robertert/FloraV2/components/flora_board/include/flora_board.h

/**
 * @file flora_board.h
 * @brief Mapa pinow jednostki dolnej (bryla): ESP32-S3 DevKitC-1 N16R8.
 *
 * Jedno miejsce prawdy dla pinoutu. Zmieniasz tu, nie w sterownikach.
 *
 * Piny, ktorych NIE wolno uzywac na tej plytce:
 *   0, 3, 45, 46  - strapping (stan przy boot decyduje o trybie startu)
 *   19, 20        - USB D-/D+
 *   35, 36, 37    - PSRAM (wariant N16R8)
 *   43, 44        - UART0 (konsola, idf.py monitor)
 *   38, 48        - dioda RGB
 */
#pragma once

#include "driver/gpio.h"

/* ---- Naped: Cytron MDD10A (PWM + DIR, logika 3,3V) ---- */
#define FLORA_PIN_MOTOR_L_PWM GPIO_NUM_4
#define FLORA_PIN_MOTOR_L_DIR GPIO_NUM_5
#define FLORA_PIN_MOTOR_R_PWM GPIO_NUM_6
#define FLORA_PIN_MOTOR_R_DIR GPIO_NUM_7

/* ---- Enkodery Halla JGB37-520, 11 PPR na wale silnika ---- */
#define FLORA_PIN_ENC_L_A GPIO_NUM_15
#define FLORA_PIN_ENC_L_B GPIO_NUM_16
#define FLORA_PIN_ENC_R_A GPIO_NUM_17
#define FLORA_PIN_ENC_R_B GPIO_NUM_18

/* ---- I2C (INA226) ---- */
#define FLORA_PIN_I2C_SDA GPIO_NUM_8
#define FLORA_PIN_I2C_SCL GPIO_NUM_9

/* ---- UART do glowicy masztu ---- */
#define FLORA_PIN_HEAD_TX GPIO_NUM_11
#define FLORA_PIN_HEAD_RX GPIO_NUM_12

/* ---- Ultradzwieki JSN-SR04T (wspolny TRIG, echo przez dzielnik) ---- */
#define FLORA_PIN_US_TRIG GPIO_NUM_13
#define FLORA_PIN_US_ECHO_1 GPIO_NUM_14
#define FLORA_PIN_US_ECHO_2 GPIO_NUM_21
#define FLORA_PIN_US_ECHO_3 GPIO_NUM_47

/* ---- Pozostale peryferia ---- */
#define FLORA_PIN_SOIL_ADC GPIO_NUM_1     /**< wilgotnosc gleby, ADC1 kanal 0 */
#define FLORA_PIN_WATER_LEVEL GPIO_NUM_10 /**< XKC-Y25, wyjscie podciagniete do 3,3V */
#define FLORA_PIN_DS18B20 GPIO_NUM_41     /**< 1-Wire, + 4,7k do 3,3V */
#define FLORA_PIN_MAST_SWITCH GPIO_NUM_39 /**< IRF4905 + NPN, klucz 12V masztu */
#define FLORA_PIN_PUMP GPIO_NUM_40        /**< D4184, pompka perystaltyczna */

/* ---- Parametry mechaniczne napedu ----
 * Enkoder daje 11 impulsow na obrot WALU SILNIKA. PCNT w trybie kwadraturowym
 * zlicza 4 zbocza na impuls, wiec na obrot wyjscia przekladni przypada:
 *     11 * 4 * przelozenie
 * Przy 270:1 to 11880 zliczen na obrot kola.
 */
#define FLORA_ENCODER_PPR 11      /**< impulsow na obrot walu silnika */
#define FLORA_ENCODER_QUAD_MULT 4 /**< dekodowanie x4 (oba zbocza, oba kanaly) */
#define FLORA_GEAR_RATIO 270.0f /**< potwierdzone przy zakupie silnikow 27.10.2026 */

/**
 * SKUTECZNA srednica kola, nie nominalna.
 *
 * Kola maja nominalnie 130 mm, ale pod ciezarem robota guma sie ugina
 * i promien toczny jest mniejszy.
 *
 * Zmierzone 27.10.2026 na podlodze, trzy przejazdy po 5 s na 40% mocy:
 *   linijka:    427,5 / 432,5 / 430,0 mm   (srednia 430,0, rozrzut 0,6%)
 *   odometria:  452 / 450 mm przy 130 mm   (srednia 450,5)
 *   wspolczynnik 450,5 / 430,0 = 1,048  ->  130 / 1,048 = 124 mm
 *
 * Pierwsza wersja miala 123 mm, policzone z samego pierwszego przejazdu -
 * a ten poszedl lukiem (8,2% roznicy miedzy kolami), wiec linijka mierzyla
 * cieciwe zamiast luku i zanizala droge. Trzy przejazdy razem daja 124 mm.
 *
 * DLACZEGO TUTAJ, A NIE W PRZELOZENIU: oba parametry wchodza do
 * FLORA_MM_PER_COUNT tak samo, wiec matematycznie mozna bylo wpisac
 * 285:1 i zostawic 130 mm. Ale 270:1 to fakt produkcyjny silnika,
 * a promien toczny zalezy od obciazenia i podloza - i to on sie zmieni
 * po wymianie kol albo po zjechaniu na trawe. Poprawka siedzi tam,
 * gdzie lezy jej przyczyna.
 *
 * ================== WARTOSC TYMCZASOWA ==================
 * Zmierzona na PLATFORNIE TESTOWEJ, nie na docelowym robocie. Promien
 * toczny zalezy od obciazenia, a docelowo dojda: bateria LiFePO4 12 Ah,
 * zbiornik 2-3 l wody, maszt z glowica, obudowa ASA. To spory ulamek
 * masy, wiec guma ugnie sie mocniej i srednica bedzie MNIEJSZA niz 124.
 *
 * Dojdzie tez podloze: na trawie kolo zaglebia sie w darn.
 *
 * POWTORZ KALIBRACJE na zmontowanym robocie, na trawie, procedura
 * bringup_drive_calibrate(): kilka przejazdow, pomiar linijka, srednia.
 *
 * SUBTELNOSC, O KTOREJ WARTO PAMIETAC: zbiornik oprozniasz sie w trakcie
 * pracy, wiec masa robota maleje o 2-3 kg i skuteczna srednica rosnie
 * w ciagu dnia. Odometria bedzie przez to dryfowac niezaleznie od
 * jakosci kalibracji - to jeden z powodow, dla ktorych korekta pozycji
 * znacznikami AprilTag nie jest dodatkiem, tylko koniecznoscia.
 * ========================================================
 */
#define FLORA_WHEEL_DIAMETER_MM 124.0f

#define FLORA_COUNTS_PER_WHEEL_REV \
    (FLORA_ENCODER_PPR * FLORA_ENCODER_QUAD_MULT * FLORA_GEAR_RATIO)

/** Droga w mm na jedno zliczenie enkodera. */
#define FLORA_MM_PER_COUNT \
    ((3.14159265f * FLORA_WHEEL_DIAMETER_MM) / FLORA_COUNTS_PER_WHEEL_REV)

/* ---- Kalibracja czujnika wilgotnosci gleby ----
 * Zmierzone 2026-10-15 na egzemplarzu zamontowanym w robocie.
 * Czujnik pojemnosciowy: sucho daje WYZSZY odczyt niz mokro.
 *
 * Uwaga przy interpretacji: punkt "mokro" zdjety w czystej wodzie oznacza
 * pelne zanurzenie, czego gleba nigdy nie osiaga. W ziemi odczyty beda
 * siegac realnie 60-80%, i to jest poprawne - to skala wzgledna, a nie
 * objetosciowa zawartosc wody.
 */
#define FLORA_SOIL_RAW_DRY 3340 /**< w powietrzu */
#define FLORA_SOIL_RAW_WET 1125 /**< zanurzony w wodzie (zmierzone 1120-1130) */

/* ---- Klucze w NVS ----
 * Nazwy sa po angielsku, jak reszta identyfikatorow, i trzymane obok
 * wartosci domyslnych - bo to wlasnie ta para musi sie zgadzac. Stale
 * zamiast literalow, zeby literowka nie przechodzila po cichu jako
 * "klucza nie ma, biore domyslna".
 *
 * Limit NVS to 15 znakow na klucz i na nazwe przestrzeni.
 */
#define FLORA_NVS_NS_CALIB "calib"
#define FLORA_NVS_SOIL_DRY "soil_dry"
#define FLORA_NVS_SOIL_WET "soil_wet"
#define FLORA_NVS_GEAR_RATIO "gear_ratio"
#define FLORA_NVS_ENC_SWAPPED "enc_swapped"
#define FLORA_NVS_MOTOR_L_INV "motor_l_inv"
#define FLORA_NVS_MOTOR_R_INV "motor_r_inv"
#define FLORA_NVS_ENC_L_INV "enc_l_inv"
#define FLORA_NVS_ENC_R_INV "enc_r_inv"
#define FLORA_NVS_GYRO_BIAS_X "gyro_bias_x"
#define FLORA_NVS_GYRO_BIAS_Y "gyro_bias_y"
#define FLORA_NVS_GYRO_BIAS_Z "gyro_bias_z"

/* ---- Siec: WiFi i MQTT ----
 * ================== DO UZUPELNIENIA ==================
 * Na razie wpisane na sztywno. Sluza jako wartosci DOMYSLNE - aplikacja
 * czyta je z NVS, wiec po pierwszym zapisaniu zmiana nie wymaga juz
 * rekompilacji. Tym samym wzorcem co kalibracja gleby.
 *
 * Uwaga: te stale trafiaja do binarki jawnym tekstem. Przed oddaniem
 * repozytorium na zewnatrz przenies je do NVS i wyczysc stad.
 * =====================================================
 */
#define FLORA_WIFI_SSID_DEFAULT "iPhone Robert"
#define FLORA_WIFI_PASS_DEFAULT "SWER1234"
/* Broker docelowy: serwer (tools/server), MQTT z TLS i logowaniem.
 * Login nie jest tajny, wiec jest tutaj. HASLA TU NIE MA: robot bierze je
 * z NVS (cmd/config/mqtt_pass), zeby nie trafialo do repo ani do binarek
 * rozsylanych przez OTA. Po erase-flash trzeba je wpisac raz ponownie. */
#define FLORA_MQTT_URI_DEFAULT "mqtts://vps-91a4a09b.vps.ovh.ca:8883"
#define FLORA_MQTT_USER_DEFAULT "robot1"
/* Zapas: broker na Macu, bez hasel, po nazwie mDNS (DHCP hotspotu zmienia
 * adresy, nazwa zostaje; `scutil --get LocalHostName`). Robot probuje go,
 * gdy serwer nie odpowiada - w domu bez internetu, albo bez hasla w NVS -
 * i wtedy da sie go naprawic z lokalnego panelu. */
#define FLORA_MQTT_URI_LOCAL "mqtt://Roberts-MacBook-Pro.local:1883"
#define FLORA_MQTT_BASE_TOPIC "flora/robot1"

#define FLORA_NVS_NS_NET "net"
#define FLORA_NVS_WIFI_SSID "wifi_ssid"
#define FLORA_NVS_WIFI_PASS "wifi_pass"
#define FLORA_NVS_MQTT_URI "mqtt_uri"
/* Login i haslo brokera. Bez wpisu w NVS login to FLORA_MQTT_USER_DEFAULT,
 * a hasla nie ma wcale. Ustawiane zdalnie: cmd/config/mqtt_user, mqtt_pass. */
#define FLORA_NVS_MQTT_USER "mqtt_user"
#define FLORA_NVS_MQTT_PASS "mqtt_pass"

/* ---- Diagnostyka ---- */
#define FLORA_NVS_NS_SYS "sys"
#define FLORA_NVS_BOOT_COUNT "boot_count" /**< licznik startow, do wykrycia petli restartow */

/* ---- Zasilanie ---- */
#define FLORA_SHUNT_MILLIOHM 10.0f /**< INA226 z rezystorem R010 */
#define FLORA_BATTERY_CELLS 4      /**< LiFePO4 4S, 12,8V nominalnie */
