robertert/FloraV2/hub/main/bringup_drive.c

/**
 * @file bringup_drive.c
 * @brief Test rozruchowy napedu: silniki, enkodery, diagnostyka sygnalu.
 *
 * Wydzielone z main.c po zakonczeniu rozruchu napedu (2026-10-15). Kod
 * zostaje, bo diagnostyka zbocz jest narzedziem wielokrotnego uzytku -
 * to ona wykryla urwany kanal A prawego enkodera na GPIO17.
 *
 * Uruchomienie: bringup_drive_run(ina) z app_main().
 * UWAGA: kola musza byc w powietrzu.
 */
#include <inttypes.h>
#include <math.h>
#include <stdio.h>
#include <stdlib.h>

#include "freertos/FreeRTOS.h"
#include "freertos/task.h"

#include "esp_log.h"
#include "esp_err.h"
#include "esp_check.h"
#include "esp_timer.h"

#include "bringup_drive.h"
#include "flora_board.h"
#include "flora_motors.h"
#include "flora_encoders.h"
#include "flora_ina226.h"

static const char *TAG = "naped";

static flora_ina226_handle_t s_ina;   /* przekazywany do bringup_drive_run */

/* Liczniki sprawdzen sa definiowane nizej; tu deklaracja wyprzedzajaca. */
static int s_checks_passed;
static int s_checks_failed;
static void check(bool ok, const char *what, const char *hint);

/* Gdy true, zrodlo zliczen klamie o bezruchu - sluzy do sprawdzenia,
 * czy straznik utyku naprawde odcina silniki. */
static bool  s_fake_frozen;
/* Gdy dodatnie, zrodlo pradu klamie - sprawdza detektor pradowy bez
 * faktycznego blokowania silnika. */
static float s_fake_current;

/** Zrodlo pradu dla straznika. NAN, gdy INA226 niedostepny. */
static float bus_current(void *ctx)
{
    if (s_fake_current > 0.0f) {
        return s_fake_current;
    }
    if (!s_ina) {
        return NAN;
    }
    float a = 0.0f;
    return flora_ina226_read_current(s_ina, &a) == ESP_OK ? a : NAN;
}

/** Zrodlo zliczen dla straznika utyku w flora_motors. */
static int64_t encoder_counts(flora_motors_wheel_t wheel, void *ctx)
{
    if (s_fake_frozen) {
        return 0;
    }
    flora_encoders_sample_t s;
    if (flora_encoders_read(&s) != ESP_OK) {
        return 0;
    }
    return wheel == FLORA_MOTORS_WHEEL_LEFT ? s.left_counts : s.right_counts;
}

static void on_stall(flora_motors_stall_reason_t reason, flora_motors_wheel_t wheel,
                     float value, void *ctx)
{
    if (reason == FLORA_MOTORS_STALL_OVERCURRENT) {
        ESP_LOGE(TAG, ">>> straznik odcial naped: prad %.2f A", value);
    } else {
        ESP_LOGE(TAG, ">>> straznik odcial naped: %s kolo nie rusza przy %.0f%%",
                 wheel == FLORA_MOTORS_WHEEL_LEFT ? "lewe" : "prawe", value);
    }
}

/**
 * Sprawdza, ze straznik utyku dziala - przez oklamanie go co do ruchu.
 *
 * Bez tego mielibysmy zabezpieczenie, o ktorym tylko zakladamy, ze zadziala.
 * Silniki dostaja niska moc na niecala sekunde, kola moga sie krecic.
 */
static void test_stall_guard(void)
{
    ESP_LOGI(TAG, "=== SPRAWDZENIE STRAZNIKA UTYKU ===");

    if (flora_motors_is_stalled()) {
        flora_motors_clear_stall();
    }

    s_fake_frozen = true;              /* od teraz enkodery "stoja" */
    int64_t t0 = esp_timer_get_time();
    flora_motors_set(20.0f, 20.0f);

    /* Czekamy do odciecia, z zapasem ponad grace_ms. */
    while (!flora_motors_is_stalled() && (esp_timer_get_time() - t0) < 2000000) {
        vTaskDelay(pdMS_TO_TICKS(20));
    }
    int64_t elapsed_ms = (esp_timer_get_time() - t0) / 1000;
    s_fake_frozen = false;

    if (flora_motors_is_stalled()) {
        ESP_LOGI(TAG, "  [ OK ] odcieto po %" PRId64 " ms", elapsed_ms);
        s_checks_passed++;

        /* Zatrzask musi odrzucac moc do czasu jawnego skasowania. */
        if (flora_motors_set(30.0f, 30.0f) == ESP_ERR_INVALID_STATE) {
            ESP_LOGI(TAG, "  [ OK ] zatrzask odrzuca zadanie mocy");
            s_checks_passed++;
        } else {
            ESP_LOGE(TAG, "  [BLAD] zatrzask przepuscil moc po utyku");
            s_checks_failed++;
            flora_motors_stop();
        }
        flora_motors_clear_stall();
    } else {
        ESP_LOGE(TAG, "  [BLAD] straznik NIE odcial w ciagu 2 s");
        s_checks_failed++;
        flora_motors_stop();
    }
    vTaskDelay(pdMS_TO_TICKS(400));
}

/**
 * Sprawdza detektor pradowy, podajac mu falszywy odczyt ponad progiem.
 *
 * Alternatywa byloby fizyczne zablokowanie kola, czyli dokladnie to,
 * przed czym detektor ma chronic - i co raz juz kosztowalo silnik.
 * Oklamanie zrodla pomiaru sprawdza ta sama sciezke kodu bez ryzyka.
 */
static void test_current_guard(void)
{
    ESP_LOGI(TAG, "=== SPRAWDZENIE DETEKTORA PRADOWEGO ===");

    if (!s_ina) {
        ESP_LOGW(TAG, "  pominiete: INA226 niedostepny, detektor nieaktywny");
        return;
    }
    if (flora_motors_is_stalled()) {
        flora_motors_clear_stall();
    }

    s_fake_current = 5.0f;            /* znacznie ponad progiem 2,5 A */
    int64_t t0 = esp_timer_get_time();
    flora_motors_set(20.0f, 20.0f);

    while (!flora_motors_is_stalled() && (esp_timer_get_time() - t0) < 2000000) {
        vTaskDelay(pdMS_TO_TICKS(20));
    }
    int64_t elapsed_ms = (esp_timer_get_time() - t0) / 1000;
    s_fake_current = 0.0f;

    if (!flora_motors_is_stalled()) {
        ESP_LOGE(TAG, "  [BLAD] detektor NIE odcial w ciagu 2 s");
        s_checks_failed++;
        flora_motors_stop();
        return;
    }

    char what[80];
    snprintf(what, sizeof(what), "odcieto po %" PRId64 " ms", elapsed_ms);
    check(true, what, NULL);

    /* Powod musi byc rozpoznany poprawnie - inaczej warstwa wyzej
     * zareaguje na zla przyczyne. */
    check(flora_motors_stall_reason() == FLORA_MOTORS_STALL_OVERCURRENT,
          "powod rozpoznany jako przekroczenie pradu", NULL);

    flora_motors_clear_stall();
    vTaskDelay(pdMS_TO_TICKS(300));

    /* Po skasowaniu blokady i powrocie pradu do normy naped musi znow
     * przyjmowac moc - inaczej jeden skok pradu zablokowalby robota na stale. */
    bool recovered = (flora_motors_set(15.0f, 15.0f) == ESP_OK);
    flora_motors_stop();
    check(recovered, "naped dziala po skasowaniu blokady",
          "zatrzask nie puszcza mimo flora_motors_clear_stall()");

    vTaskDelay(pdMS_TO_TICKS(300));
}

/* Moc uzywana w testach. 30% wystarczy, zeby kolo ruszylo bez obciazenia. */
#define TEST_POWER        30.0f
#define TEST_DURATION_MS  1500
#define SETTLE_MS         600
#define MIN_COUNTS_MOVED  50

static int s_checks_passed;
static int s_checks_failed;

static void check(bool ok, const char *what, const char *hint)
{
    if (ok) {
        s_checks_passed++;
        ESP_LOGI(TAG, "  [ OK ] %s", what);
    } else {
        s_checks_failed++;
        ESP_LOGE(TAG, "  [BLAD] %s", what);
        if (hint) {
            ESP_LOGE(TAG, "         podpowiedz: %s", hint);
        }
    }
}

static float log_power(const char *moment)
{
    if (!s_ina) {
        return NAN;   /* brak ukladu: milczymy, zamiast powtarzac to samo ostrzezenie */
    }
    flora_ina226_reading_t r;
    if (flora_ina226_read(s_ina, &r) != ESP_OK) {
        ESP_LOGW(TAG, "  %s: odczyt INA226 nie powiodl sie", moment);
        return NAN;
    }
    ESP_LOGI(TAG, "  %s: %.2f V, %.3f A, %.2f W (bocznik %.3f mV)",
             moment, r.bus_voltage_v, r.current_a, r.power_w, r.shunt_voltage_mv);
    return r.current_a;
}

/**
 * Prog, powyzej ktorego uznajemy ze sterownik faktycznie ciagnie prad.
 * Sam MDD10A na logike bierze wiecej niz 20 mA, wiec ponizej tej wartosci
 * mozna powiedziec z cala pewnoscia, ze przez bocznik nic nie plynie.
 */
#define CURRENT_ALIVE_A  0.020f

/**
 * Jeden przebieg: zadaje moc, mierzy przyrost zliczen i prad.
 *
 * @param expect_left   spodziewany kierunek lewego kola: +1, -1 albo 0 (ma stac)
 */
/* Wynik przebiegu "jazda prosto" - potrzebny do werdyktu o kierunku. */
static int64_t s_straight_left;
static int64_t s_straight_right;
static bool    s_straight_done;

static void run_leg(const char *name, float left_power, float right_power,
                    int expect_left, int expect_right)
{
    ESP_LOGI(TAG, "--- %s (L=%.0f%%, P=%.0f%%) ---", name, left_power, right_power);

    flora_encoders_sample_t before, after;
    ESP_ERROR_CHECK(flora_encoders_read(&before));

    float idle_a = log_power("przed ruchem");

    ESP_ERROR_CHECK(flora_motors_set(left_power, right_power));
    vTaskDelay(pdMS_TO_TICKS(TEST_DURATION_MS / 2));
    float load_a = log_power("pod obciazeniem");
    vTaskDelay(pdMS_TO_TICKS(TEST_DURATION_MS / 2));

    /* Czy przez bocznik w ogole cokolwiek poplynelo. */
    bool current_flowed = !isnan(idle_a) && !isnan(load_a)
                          && fabsf(load_a - idle_a) > CURRENT_ALIVE_A;
    bool current_known = !isnan(idle_a) && !isnan(load_a);

    ESP_ERROR_CHECK(flora_encoders_read(&after));
    ESP_ERROR_CHECK(flora_motors_stop());

    int64_t dl = after.left_counts  - before.left_counts;
    int64_t dr = after.right_counts - before.right_counts;

    if (expect_left > 0 && expect_right > 0) {
        s_straight_left  = dl;
        s_straight_right = dr;
        s_straight_done  = true;
    }
    float speed_l = 0.0f, speed_r = 0.0f;
    flora_encoders_speed_mm_s(&before, &after, &speed_l, &speed_r);

    ESP_LOGI(TAG, "  lewe:  %+8" PRId64 " zliczen (%+7.1f mm, %+6.1f mm/s)",
             dl, after.left_mm - before.left_mm, speed_l);
    ESP_LOGI(TAG, "  prawe: %+8" PRId64 " zliczen (%+7.1f mm, %+6.1f mm/s)",
             dr, after.right_mm - before.right_mm, speed_r);

    struct { int64_t delta; int expect; const char *wheel; } wheels[] = {
        { dl, expect_left,  "lewe"  },
        { dr, expect_right, "prawe" },
    };

    for (int i = 0; i < 2; i++) {
        char what[96];
        if (wheels[i].expect == 0) {
            snprintf(what, sizeof(what), "%s kolo stoi", wheels[i].wheel);
            check(llabs(wheels[i].delta) < MIN_COUNTS_MOVED, what,
                  "liczy mimo zerowej mocy. Najczesciej ZAMIENIONE STRONAMI "
                  "ENKODERY (to wejscie czyta drugie kolo) - sprawdz w sekcji "
                  "DIAGNOSTYKA ENKODEROW, ktore piny ruszaja sie przy ktorym "
                  "silniku. Rzadziej: zamienione kanaly PWM albo DIR");
            continue;
        }

        snprintf(what, sizeof(what), "%s kolo sie krecilo", wheels[i].wheel);
        bool moved = llabs(wheels[i].delta) >= MIN_COUNTS_MOVED;

        /* Prad rozdziela dwie zupelnie rozne awarie: albo silnik sie nie
         * kreci (problem zasilania lub sygnalu), albo kreci sie, ale enkoder
         * nie liczy. Bez tego rozroznienia podpowiedz byla zgadywaniem. */
        const char *hint;
        if (current_known && !current_flowed) {
            /* Uwaga: to NIE dowodzi, ze silnik stoi. Jesli enkoder liczy
             * zbocza, silnik sie kreci, a zerowy prad oznacza tylko tyle,
             * ze bocznik INA226 lezy poza torem pradu silnikow. */
            hint = "przez bocznik nie poplynal prad. Jesli silniki sie kreca, "
                   "to bocznik INA226 nie jest w torze pradu - musi byc wpiety "
                   "SZEREGOWO (IN+ od baterii, IN- do odbiornikow), a MDD10A "
                   "nie moze brac 12V z punktu przed modulem. "
                   "Jesli silniki stoja - sprawdz wspolna mase i zasilanie MDD10A";
        } else if (current_known) {
            hint = "prad plynie, wiec silnik dostaje moc, ale enkoder nie liczy: "
                   "sprawdz zasilanie enkodera z 3,3V (nie z 5V), piny A i B "
                   "oraz czy masa enkodera jest wspolna z ESP32";
        } else {
            hint = "brak zliczen: sprawdz zasilanie enkodera z 3,3V, piny A/B, "
                   "zasilanie silnika i czy MDD10A ma 12V";
        }
        check(moved, what, hint);

        if (moved) {
            snprintf(what, sizeof(what), "%s kolo w dobrym kierunku", wheels[i].wheel);
            bool right_way = (wheels[i].delta > 0) == (wheels[i].expect > 0);
            check(right_way, what,
                  "kreci sie odwrotnie: ustaw invert=true dla tego kola "
                  "(w flora_motors gdy wirnik jedzie zle, w flora_encoders gdy "
                  "jedzie dobrze a zliczenia maleja)");
        }
    }

    vTaskDelay(pdMS_TO_TICKS(SETTLE_MS));
}


/* ================= DIAGNOSTYKA ================= */

/** Odczytuje surowe poziomy na czterech pinach enkoderow. */
static void diag_pin_levels(const char *when)
{
    ESP_LOGI(TAG, "  %-18s L_A=%d L_B=%d | P_A=%d P_B=%d", when,
             gpio_get_level(FLORA_PIN_ENC_L_A), gpio_get_level(FLORA_PIN_ENC_L_B),
             gpio_get_level(FLORA_PIN_ENC_R_A), gpio_get_level(FLORA_PIN_ENC_R_B));
}

/**
 * Liczy zbocza na pinach enkoderow programowo, niezaleznie od PCNT.
 *
 * To jest sedno diagnozy: rozdziela "na pinie nic sie nie dzieje" (problem
 * sprzetowy: brak enkodera, brak zasilania, zly pin) od "sygnal jest, ale
 * PCNT go nie liczy" (problem konfiguracji sterownika).
 */
static void diag_edge_count(const char *name, float left_power, float right_power)
{
    const gpio_num_t pins[4] = {
        FLORA_PIN_ENC_L_A, FLORA_PIN_ENC_L_B,
        FLORA_PIN_ENC_R_A, FLORA_PIN_ENC_R_B,
    };
    /* Etykietujemy numerem pinu, nie strona: mapowanie strona->pin bywa
     * zamienione w okablowaniu i wtedy "L_A" klamie. Piny nie klamia. */
    char labels[4][12];
    for (int i = 0; i < 4; i++) {
        snprintf(labels[i], sizeof(labels[i]), "GPIO%d_%c", pins[i], (i % 2) ? 'B' : 'A');
    }

    int  last[4];
    int  edges[4] = { 0 };
    for (int i = 0; i < 4; i++) {
        last[i] = gpio_get_level(pins[i]);
    }

    flora_encoders_sample_t before, after;
    flora_encoders_read(&before);
    flora_motors_set(left_power, right_power);

    /* Petla ciasna, ale krotka - nie zaglodzi watchdoga (limit 5 s). */
    int64_t deadline = esp_timer_get_time() + 500000;  /* 500 ms */
    uint32_t samples = 0;
    while (esp_timer_get_time() < deadline) {
        for (int i = 0; i < 4; i++) {
            int now = gpio_get_level(pins[i]);
            if (now != last[i]) {
                edges[i]++;
                last[i] = now;
            }
        }
        samples++;
    }

    flora_motors_stop();
    flora_encoders_read(&after);

    ESP_LOGI(TAG, "  %s (%.0f probek/pin):", name, (float)samples);
    for (int i = 0; i < 4; i++) {
        ESP_LOGI(TAG, "    %s: %6d zbocz programowo", labels[i], edges[i]);
    }
    ESP_LOGI(TAG, "    PCNT: lewy %+" PRId64 ", prawy %+" PRId64,
             after.left_counts - before.left_counts,
             after.right_counts - before.right_counts);

    /* Kanal martwy przy zywym blizniaku to odlaczony przewod, nie zepsuty
     * enkoder. Bez obu kanalow PCNT nie policzy nic sensownego, bo zliczenia
     * w gore i w dol kasuja sie nawzajem. */
    /* Na wejsciu sasiadujacym z pracujacym silnikiem potrafi pojawic sie
     * kilkadziesiat zbocz czystego szumu (zmierzone 26), wiec prog
     * bezwzgledny nie wystarcza. Enkoder uznajemy za pracujacy dopiero
     * przy setkach zbocz, a martwy kanal tylko wtedy, gdy drugi wyraznie
     * pracuje. */
    const int WORKING_MIN = 100;
    for (int pair = 0; pair < 2; pair++) {
        int a = edges[pair * 2], b = edges[pair * 2 + 1];
        /* Nazywamy pinami, nie strona - mapowanie strona->pin moze byc
         * zamienione w okablowaniu. */
        char side[24];
        snprintf(side, sizeof(side), "enkoderze GPIO%d/%d",
                 pins[pair * 2], pins[pair * 2 + 1]);

        /* Kanaly A i B powinny dac niemal tyle samo zbocz. Rozjazd ponad
         * 10% oznacza gubione impulsy - zwykle chwiejny styk. */
        int bigger_ch = a > b ? a : b;
        int smaller_ch = a > b ? b : a;
        if (bigger_ch < WORKING_MIN) {
            continue;   /* ten enkoder nie pracuje - nie ma czego oceniac */
        }

        if (smaller_ch >= WORKING_MIN) {
            int diff = bigger_ch - smaller_ch;
            if (diff * 100 / bigger_ch > 10) {
                ESP_LOGW(TAG, "    -> w %s kanaly A i B rozjezdzaja sie "
                              "o %d%% (%d vs %d): gubione impulsy, "
                              "zwykle chwiejny styk albo za slabe podciagniecie",
                         side, diff * 100 / bigger_ch, a, b);
            }
            continue;
        }

        /* Jeden kanal pracuje, drugi ledwie drgnal - przerwany przewod. */
        if (a < bigger_ch / 10) {
            ESP_LOGE(TAG, "    -> w %s kanal A (GPIO%d) milczy, a B pracuje: "
                          "odlaczony przewod A", side,
                     pair == 0 ? FLORA_PIN_ENC_L_A : FLORA_PIN_ENC_R_A);
        } else if (b < bigger_ch / 10) {
            ESP_LOGE(TAG, "    -> w %s kanal B (GPIO%d) milczy, a A pracuje: "
                          "odlaczony przewod B", side,
                     pair == 0 ? FLORA_PIN_ENC_L_B : FLORA_PIN_ENC_R_B);
        }
    }

    vTaskDelay(pdMS_TO_TICKS(400));
}

/** Pelna diagnostyka toru enkoderow. */
static void diag_encoders(void)
{
    ESP_LOGI(TAG, "=== DIAGNOSTYKA ENKODEROW ===");
    ESP_LOGI(TAG, "piny: L_A=%d L_B=%d P_A=%d P_B=%d (podciagniecia wewnetrzne wlaczone)",
             FLORA_PIN_ENC_L_A, FLORA_PIN_ENC_L_B,
             FLORA_PIN_ENC_R_A, FLORA_PIN_ENC_R_B);

    /* Stan spoczynkowy. Przy wlaczonych podciagnieciach:
     *   same jedynki        -> pin wisi w powietrzu ALBO enkoder stoi na stanie wysokim
     *   same zera           -> zwarcie do masy albo enkoder trzyma stan niski
     *   mieszanka           -> cos jest podlaczone i ma rozne stany
     * Samo to nie rozstrzyga, ale razem z testem dynamicznym juz tak. */
    ESP_LOGI(TAG, "  poziomy w spoczynku (3 odczyty):");
    for (int i = 0; i < 3; i++) {
        diag_pin_levels("spoczynek");
        vTaskDelay(pdMS_TO_TICKS(100));
    }

    diag_edge_count("lewy silnik 40%",  40.0f,  0.0f);
    diag_edge_count("prawy silnik 40%",  0.0f, 40.0f);
    diag_edge_count("oba silniki 60%",  60.0f, 60.0f);

    ESP_LOGI(TAG, "  interpretacja:");
    ESP_LOGI(TAG, "    0 zbocz programowo + silnik sie kreci -> enkoder nie dociera do pinu");
    ESP_LOGI(TAG, "      (silnik bez enkodera, brak zasilania 3,3V enkodera,");
    ESP_LOGI(TAG, "       brak wspolnej masy, albo przewody A/B nie na tych pinach)");
    ESP_LOGI(TAG, "    zbocza sa, ale PCNT = 0 -> blad konfiguracji licznika");
    ESP_LOGI(TAG, "=============================");
}


/** Inicjalizuje naped i enkodery. Wolane z bringup_drive_run. */
static esp_err_t drive_hw_init(void)
{
    flora_motors_cfg_t motors_cfg = FLORA_MOTORS_DEFAULT_CFG();
    motors_cfg.left  = (flora_motor_cfg_t){ .pwm_gpio = FLORA_PIN_MOTOR_L_PWM,
                                            .dir_gpio = FLORA_PIN_MOTOR_L_DIR,
                                            .invert   = false };
    motors_cfg.right = (flora_motor_cfg_t){ .pwm_gpio = FLORA_PIN_MOTOR_R_PWM,
                                            .dir_gpio = FLORA_PIN_MOTOR_R_DIR,
                                            .invert   = true };
    ESP_RETURN_ON_ERROR(flora_motors_init(&motors_cfg), TAG, "naped");

    /* TODO (kalibracja kierunku, nierozstrzygniete 2026-10-14):
     * Oba enkodery licza UJEMNIE przy komendzie "w przod". Surowe znaki sa
     * przeciwne, czyli wzajemnie silniki kreca sie dobrze. Po zamontowaniu
     * kol w podwoziu sprawdzic przebieg "jazda prosto":
     *   jedzie w przod -> odwrocic invert w enc_cfg
     *   jedzie w tyl   -> odwrocic invert w motors_cfg */
    /* OKABLOWANIE: wtyczki enkoderow sa wpiete ODWROTNIE wzgledem pinoutu.
     * Zmierzone dwa razy, na dwoch roznych kompletach silnikow:
     *   19.10.2026 (stare silniki) i 27.10.2026 (nowe) - za kazdym razem
     *   lewy silnik kreci enkoderem na GPIO17/18, prawy na GPIO15/16.
     * Powtarzalnosc wskazuje, ze tak jest zrobiona wiazka, a nie ze ktos
     * raz pomylil wtyczki. Kompensujemy w kodzie.
     *
     * Jesli kiedys przepniesz wiazke na zgodna z pinoutem, zdejmij to
     * mapowanie - diagnostyka zbocz powie, czy nadal jest potrzebne. */
    flora_encoders_cfg_t enc_cfg = FLORA_ENCODERS_DEFAULT_CFG();
    /* Znak lewego enkodera ustalony obserwacja 27.10.2026: robot jechal
     * prosto, a enkodery pokazywaly przeciwne znaki - czyli silniki byly
     * zgodne, a mylil sie sam odczyt. */
    enc_cfg.left  = (flora_encoder_cfg_t){ .a_gpio = FLORA_PIN_ENC_R_A,   /* zamienione */
                                           .b_gpio = FLORA_PIN_ENC_R_B,
                                           .invert = true };
    enc_cfg.right = (flora_encoder_cfg_t){ .a_gpio = FLORA_PIN_ENC_L_A,   /* zamienione */
                                           .b_gpio = FLORA_PIN_ENC_L_B,
                                           .invert = true };
    enc_cfg.mm_per_count = FLORA_MM_PER_COUNT;
    ESP_RETURN_ON_ERROR(flora_encoders_init(&enc_cfg), TAG, "enkodery");

    /* Straznika utyku NIE wlaczamy tutaj. Powod wyszedl w tescie 27.10.2026:
     * zle podlaczony enkoder wyglada dla straznika dokladnie jak utyk, wiec
     * zatrzaskiwal blokade w trakcie diagnostyki i zabijal reszte testu -
     * a diagnostyka istnieje wlasnie po to, by dzialac przy zlym okablowaniu.
     * Wlaczamy go dopiero, gdy mapowanie enkoderow jest potwierdzone. */
    return ESP_OK;
}

/** Wlacza straznika utyku. Wolane po diagnostyce, nie przed. */
static esp_err_t enable_stall_guard(void)
{
    flora_motors_stall_cfg_t guard = FLORA_MOTORS_STALL_DEFAULT_CFG();
    guard.counts_cb  = encoder_counts;
    guard.on_stall   = on_stall;
    /* Drugi, niezalezny detektor. Dziala tylko, gdy INA226 odpowiada -
     * przy jego braku zostaje sam detektor enkoderowy. */
    guard.current_cb = s_ina ? bus_current : NULL;
    return flora_motors_stall_guard_enable(&guard);
}

/**
 * Jazda prosto przez staly czas, zeby porownac droge z odometrii
 * z droga zmierzona linijka. To jedyny sposob na ustalenie prawdziwego
 * przelozenia przekladni - z karty katalogowej bywa inne niz w egzemplarzu.
 */
static void calibrate_gear_ratio(void)
{
    const uint32_t drive_ms = 2000;

    ESP_LOGI(TAG, "=== KALIBRACJA PRZELOZENIA ===");
    ESP_LOGI(TAG, "  zaznacz pozycje robota, zaraz pojedzie prosto przez %" PRIu32 " ms",
             drive_ms);
    vTaskDelay(pdMS_TO_TICKS(2000));

    ESP_ERROR_CHECK(flora_encoders_reset());
    flora_encoders_sample_t before, after;
    ESP_ERROR_CHECK(flora_encoders_read(&before));

    ESP_ERROR_CHECK(flora_motors_set(TEST_POWER, TEST_POWER));
    vTaskDelay(pdMS_TO_TICKS(drive_ms));
    ESP_ERROR_CHECK(flora_motors_stop());

    /* Chwila na wybieg - inaczej policzymy mniej niz robot naprawde przejechal. */
    vTaskDelay(pdMS_TO_TICKS(600));
    ESP_ERROR_CHECK(flora_encoders_read(&after));

    float dl = fabsf(after.left_mm  - before.left_mm);
    float dr = fabsf(after.right_mm - before.right_mm);
    float avg = (dl + dr) / 2.0f;

    ESP_LOGI(TAG, "  odometria: lewe %.0f mm, prawe %.0f mm, srednio %.0f mm", dl, dr, avg);
    if (dl > 0.0f && dr > 0.0f) {
        float skew = 100.0f * fabsf(dl - dr) / avg;
        ESP_LOGI(TAG, "  roznica miedzy kolami: %.1f%%", skew);
        if (skew > 10.0f) {
            ESP_LOGW(TAG, "  ponad 10%% - jedno kolo buksuje albo silniki maja "
                          "rozna charakterystyke; PID na kolo to wyrowna");
        }
    }

    ESP_LOGI(TAG, "  --------------------------------------------------");
    ESP_LOGI(TAG, "  ZMIERZ LINIJKA faktycznie przejechana droge, potem:");
    ESP_LOGI(TAG, "    nowe_przelozenie = %.0f * (%.0f / zmierzone_mm)",
             (double)FLORA_GEAR_RATIO, avg);
    ESP_LOGI(TAG, "  i wpisz wynik w FLORA_GEAR_RATIO w flora_board.h");
    ESP_LOGI(TAG, "  (teraz przyjete %.0f:1, co daje %.4f mm na zliczenie)",
             (double)FLORA_GEAR_RATIO, (double)FLORA_MM_PER_COUNT);
    ESP_LOGI(TAG, "  --------------------------------------------------");
}

/** Mowi wprost, ktora flage invert przestawic, zaleznie od obserwacji. */
static void direction_verdict(void)
{
    if (!s_straight_done) {
        return;
    }

    ESP_LOGI(TAG, "=== KIERUNEK ===");
    ESP_LOGI(TAG, "  przy komendzie \"w przod\" enkodery policzyly: "
                  "lewe %+" PRId64 ", prawe %+" PRId64,
             s_straight_left, s_straight_right);

    bool both_negative = s_straight_left < 0 && s_straight_right < 0;
    bool both_positive = s_straight_left > 0 && s_straight_right > 0;

    if (both_positive) {
        ESP_LOGI(TAG, "  Oba dodatnie. Jesli robot pojechal DO PRZODU - wszystko gra,");
        ESP_LOGI(TAG, "  znak odometrii jest poprawny i nic nie trzeba zmieniac.");
        ESP_LOGI(TAG, "  Jesli pojechal DO TYLU - odwroc invert w OBU silnikach");
        ESP_LOGI(TAG, "  (motors_cfg w drive_hw_init) oraz w obu enkoderach.");
    } else if (both_negative) {
        ESP_LOGI(TAG, "  Oba ujemne. Teraz patrzysz, w ktora strone pojechal robot:");
        ESP_LOGI(TAG, "    DO PRZODU -> odwroc invert w OBU enkoderach (enc_cfg):");
        ESP_LOGI(TAG, "                 lewy na true, prawy na false");
        ESP_LOGI(TAG, "    DO TYLU   -> odwroc invert w OBU silnikach (motors_cfg):");
        ESP_LOGI(TAG, "                 lewy na true, prawy na false");
    } else {
        ESP_LOGW(TAG, "  Przeciwne znaki przy jezdzie prosto - kola kreca sie");
        ESP_LOGW(TAG, "  przeciwnie wzgledem siebie. Robot obraca sie zamiast jechac.");
        ESP_LOGW(TAG, "  Odwroc invert w JEDNYM silniku (motors_cfg).");
    }
}

/**
 * Sama kalibracja przelozenia, bez reszty testow.
 *
 * Przejazd jest DLUZSZY niz w pelnym tescie i to celowo: blad pomiaru
 * linijka (jakies +-2 mm) jest staly, wiec im dluzsza droga, tym mniejszy
 * jego udzial. Przy 127 mm dwa milimetry to 1,6% bledu przelozenia,
 * przy 500 mm juz tylko 0,4%.
 */
void bringup_drive_calibrate(flora_ina226_handle_t ina, int runs)
{
    s_ina = ina;
    if (drive_hw_init() != ESP_OK) {
        ESP_LOGE(TAG, "nie udalo sie zainicjalizowac napedu");
        return;
    }
    ESP_ERROR_CHECK(enable_stall_guard());

    const uint32_t drive_ms = 5000;
    const float    power    = 40.0f;

    ESP_LOGW(TAG, "========================================================");
    ESP_LOGW(TAG, " KALIBRACJA PRZELOZENIA");
    ESP_LOGW(TAG, " Robot pojedzie prosto przez %" PRIu32 " ms, %d razy.", drive_ms, runs);
    ESP_LOGW(TAG, " Potrzeba okolo metra wolnej przestrzeni na kazdy przejazd.");
    ESP_LOGW(TAG, "========================================================");

    for (int run = 1; run <= runs; run++) {
        ESP_LOGW(TAG, "--- przejazd %d z %d ---", run, runs);
        ESP_LOGW(TAG, "  ZAZNACZ pozycje robota. Start za 5 s.");
        for (int i = 5; i > 0; i--) {
            ESP_LOGW(TAG, "  %d...", i);
            vTaskDelay(pdMS_TO_TICKS(1000));
        }

        ESP_ERROR_CHECK(flora_encoders_reset());
        flora_encoders_sample_t before, after;
        ESP_ERROR_CHECK(flora_encoders_read(&before));

        ESP_ERROR_CHECK(flora_motors_set(power, power));
        vTaskDelay(pdMS_TO_TICKS(drive_ms));
        ESP_ERROR_CHECK(flora_motors_stop());

        /* Chwila na wybieg - bez tej przerwy policzymy mniej, niz robot
         * naprawde przejechal, i przelozenie wyjdzie zawyzone. */
        vTaskDelay(pdMS_TO_TICKS(800));
        ESP_ERROR_CHECK(flora_encoders_read(&after));

        float dl  = fabsf(after.left_mm  - before.left_mm);
        float dr  = fabsf(after.right_mm - before.right_mm);
        float avg = (dl + dr) / 2.0f;

        ESP_LOGI(TAG, "  odometria: lewe %.0f mm, prawe %.0f mm, SREDNIO %.0f mm", dl, dr, avg);
        if (avg > 0.0f) {
            float skew = 100.0f * fabsf(dl - dr) / avg;
            ESP_LOGI(TAG, "  roznica miedzy kolami: %.1f%%", skew);
            if (skew > 10.0f) {
                ESP_LOGW(TAG, "  ponad 10%% - kolo buksuje albo robot jedzie lukiem;");
                ESP_LOGW(TAG, "  taki przejazd slabo nadaje sie do kalibracji");
            }
        }

        /* Tabelka zamiast samego wzoru - przy pomiarze linijka wygodniej
         * odczytac gotowa wartosc, niz liczyc w pamieci. */
        ESP_LOGI(TAG, "  ZMIERZ LINIJKA faktyczna droge i odczytaj przelozenie:");
        ESP_LOGI(TAG, "    zmierzone      przelozenie");
        for (int pct = 70; pct <= 130; pct += 10) {
            float measured = avg * (float)pct / 100.0f;
            ESP_LOGI(TAG, "    %6.0f mm       %.0f:1",
                     measured, (double)(FLORA_GEAR_RATIO * avg / measured));
        }
        ESP_LOGI(TAG, "  (teraz przyjete %.0f:1, %.4f mm na zliczenie)",
                 (double)FLORA_GEAR_RATIO, (double)FLORA_MM_PER_COUNT);

        if (run < runs) {
            ESP_LOGW(TAG, "  ustaw robota na nastepny przejazd");
            vTaskDelay(pdMS_TO_TICKS(8000));
        }
    }

    ESP_LOGI(TAG, "========================================================");
    ESP_LOGI(TAG, " Usrednij wyniki z przejazdow i wpisz do FLORA_GEAR_RATIO");
    ESP_LOGI(TAG, " w components/flora_board/include/flora_board.h");
    ESP_LOGI(TAG, "========================================================");
}

void bringup_drive_run(flora_ina226_handle_t ina)
{
    s_ina = ina;
    if (drive_hw_init() != ESP_OK) {
        ESP_LOGE(TAG, "nie udalo sie zainicjalizowac napedu, pomijam test");
        return;
    }
    s_checks_passed = 0;
    s_checks_failed = 0;

    ESP_LOGW(TAG, "========================================================");
    ESP_LOGW(TAG, " TEST NAPEDU");
    ESP_LOGW(TAG, " Robot POJEDZIE. Potrzeba ok. 1 m wolnej przestrzeni");
    ESP_LOGW(TAG, " i plaskiego podloza - albo postaw go na podstawkach.");
    ESP_LOGW(TAG, " Start za 5 s");
    ESP_LOGW(TAG, "========================================================");
    for (int i = 5; i > 0; i--) {
        ESP_LOGW(TAG, " %d...", i);
        vTaskDelay(pdMS_TO_TICKS(1000));
    }

    /* Samotest straznika wymaga go wlaczonego, wiec wlaczamy, sprawdzamy
     * i wylaczamy na czas diagnostyki. */
    ESP_ERROR_CHECK(enable_stall_guard());
    test_stall_guard();
    test_current_guard();
    ESP_ERROR_CHECK(flora_motors_stall_guard_disable());

    ESP_ERROR_CHECK(flora_encoders_reset());
    diag_encoders();
    ESP_ERROR_CHECK(flora_encoders_reset());

    /* Mapowanie enkoderow juz znane - od tego miejsca straznik chroni. */
    ESP_ERROR_CHECK(enable_stall_guard());

    run_leg("lewe kolo w przod",  TEST_POWER, 0.0f, +1, 0);
    run_leg("lewe kolo w tyl",   -TEST_POWER, 0.0f, -1, 0);
    run_leg("prawe kolo w przod", 0.0f,  TEST_POWER, 0, +1);
    run_leg("prawe kolo w tyl",   0.0f, -TEST_POWER, 0, -1);
    run_leg("jazda prosto",  TEST_POWER,  TEST_POWER, +1, +1);
    run_leg("jazda w tyl",  -TEST_POWER, -TEST_POWER, -1, -1);
    run_leg("obrot w miejscu", TEST_POWER, -TEST_POWER, +1, -1);

    if (flora_motors_is_stalled()) {
        ESP_LOGE(TAG, "########################################################");
        ESP_LOGE(TAG, " PRZERWANO: straznik wykryl utyk %s kola.",
                 flora_motors_stalled_wheel() == FLORA_MOTORS_WHEEL_LEFT ? "lewego" : "prawego");
        ESP_LOGE(TAG, " Sprawdz, czy kolo nie jest zablokowane, zanim sprobujesz");
        ESP_LOGE(TAG, " ponownie. Dalsze przebiegi pominiete.");
        ESP_LOGE(TAG, "########################################################");
        return;
    }

    direction_verdict();
    calibrate_gear_ratio();

    ESP_LOGI(TAG, "========================================================");
    if (s_checks_failed == 0) {
        ESP_LOGI(TAG, " WYNIK: wszystko przeszlo (%d sprawdzen)", s_checks_passed);
    } else {
        ESP_LOGE(TAG, " WYNIK: %d przeszlo, %d nie przeszlo", s_checks_passed, s_checks_failed);
    }
    ESP_LOGI(TAG, "========================================================");
}
