robertert/FloraV2/(commit log)

2026-10-15 feat: added temp sensor and pump control
2026-10-20 feat: added schema+ soil + pump
    [schemat.kicad_pcb, schemat.kicad_sch]
2026-10-21 feat: electrical schema part
    [schemat.kicad_sch]
2026-10-21 feat: added UART communiaction protocol hub - node
2026-10-21 feat: schema no jsx
    [schemat.kicad_sch]
2026-10-21 feat: added jsx
    [schemat.kicad_sch]
2026-10-21 feat: finished schema
    [schemat.kicad_sch]
2026-10-22 feat: finished pcb v1.0
    [schemat.kicad_pcb, schemat.kicad_sch]
2026-10-22 feat: generate gerber
    [schemat-B_Cu.gbr, schemat-B_Mask.gbr, schemat-B_Silkscreen.gbr, schemat-Edge_Cuts.gbr, schemat-F_Cu.gbr, schemat-F_Mask.gbr, schemat-F_Silkscreen.gbr, schemat-NPTH.drl]
2026-10-28 feat: wykrywanie utyku po pradzie i kalibracja odometrii
2026-10-31 feat: added maszt schema
    [maszt_schemat.kicad_pcb, maszt_schemat.kicad_sch]
2026-11-02 feat: camera-based obstacle detection
2026-11-02 feat: run head camera without network by default
